BrandonTowell/Capstone-Team-12/Documentation/T12 Capstone Poster 2.1.pptx

Signal Integrity Education
By: Travis Berger and Luis Santiago
Sponsor: Tony Muilenburg Advisor: Dr. James Morris

Background

In order for students and industry members to build an intuition for signal integrity issues Intel developed an educational board to demonstrate these issues with a physical circuit. The Education Engagement Electrical Validation Board E3VB Helps bridge the gap between theory learned in the classroom and common problems that occur while measuring circuits the bench.

Education Engagement
Electrical Validation Board

Objective

Intersymbol Interference


The traces are routed 6 mil apart to induce crosstalk between them . Different inductor values can be selected to magnify the intersymbol interference

The objective of this capstone project was to help improve the E3VB by adding new experiments to the existing board. These experiments were required to work independently from the E3VB but still be capable of being added to the E3VB in a future revision .

Mixed Signal Ground Technique

The goal of this experiment was to highlight signal integrity issues that occur with improper grounding when a board contains both analog and digital circuity.


Victim line with no aggressors


Transmission line with two
aggressor on each side


Analog signal without digital
Interference


Analog signal with isolated
GND planes

Current Experiments

- Crosstalk
- Decoupling
- Corners and Vias
- Mystery Traces
- Simultaneous Switching Noise
- LCR Transmission Lines
- Driver Circuit Comparison
- Package Differences
- Intersymbol Interference

The goal of this experiment was to expand on the Intersymbol Interference and the Crosstalk experiments currently on the E3VB. This experiment used four aggressor lines in parallel to show the effects on a nearby victim line. An LFSR was used to create a random pattern generator for each trace. This shows that the effect on the signal depends on both the previous symbols and the nearby signals.


Analog signal with shared
return path

Department of Electrical and Computer Engineering
