BrandonTowell/Capstone-Team-12/Documentation/T12 Final Presentation.pptx

## Signal Integrity Education

June 2015
Team 12
Owners: Travis Berger, Luis Santiago

## Objective

- The objective of this Capstone Project was to create two experiment boards that help students build an intuition for signal integrity issues.

## Experiments

- Mixed Signal Ground Techniques
- ISI/Crosstalk

## Mixed Signal Ground Techniques

Digital Circuity With
Semi-Isolated Ground Plane

Return Path B

Return Path A

Analog Circuity

Source

Isolation

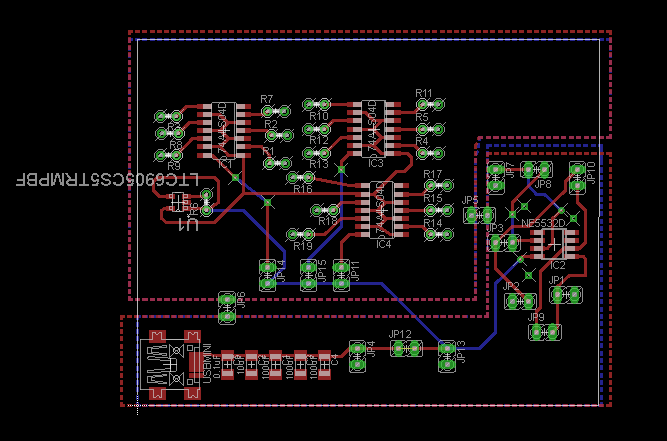
[picture p22: figure]

## MSGT Measurement results

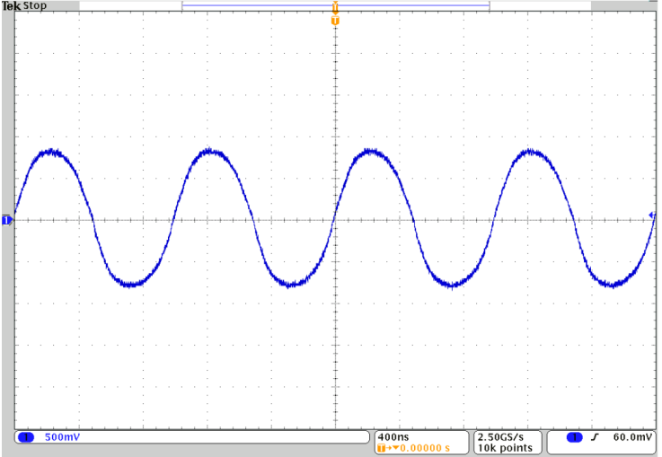
[picture p23: figure]
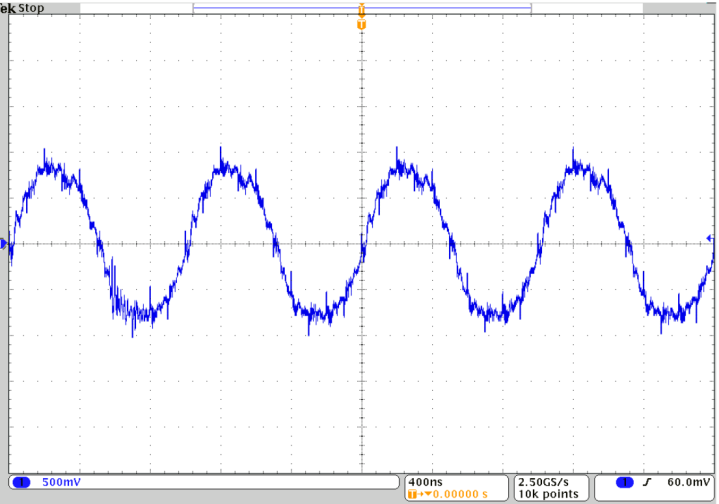
[picture p24: figure]
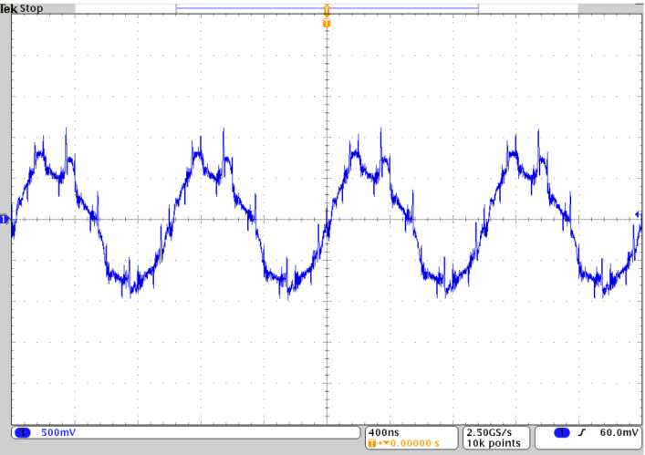
[picture p25: figure]

Analog signal without digital
Interference

## ISI/Crosstalk Experiment


## ISI Finished Board

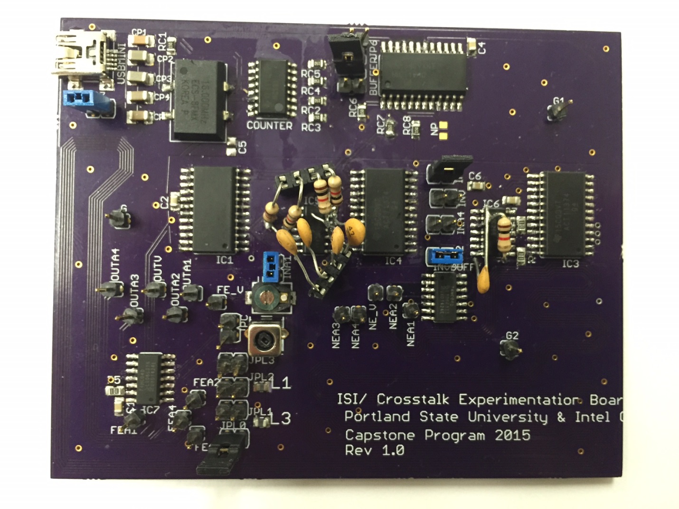
[picture p26: figure]

## ISI Measurement Results


## Testing Approach

- Modular Testing
- Integrated Testing

## Testing

- Modular testing breakout boards
- Integrated testing of CLK and loaded inverter

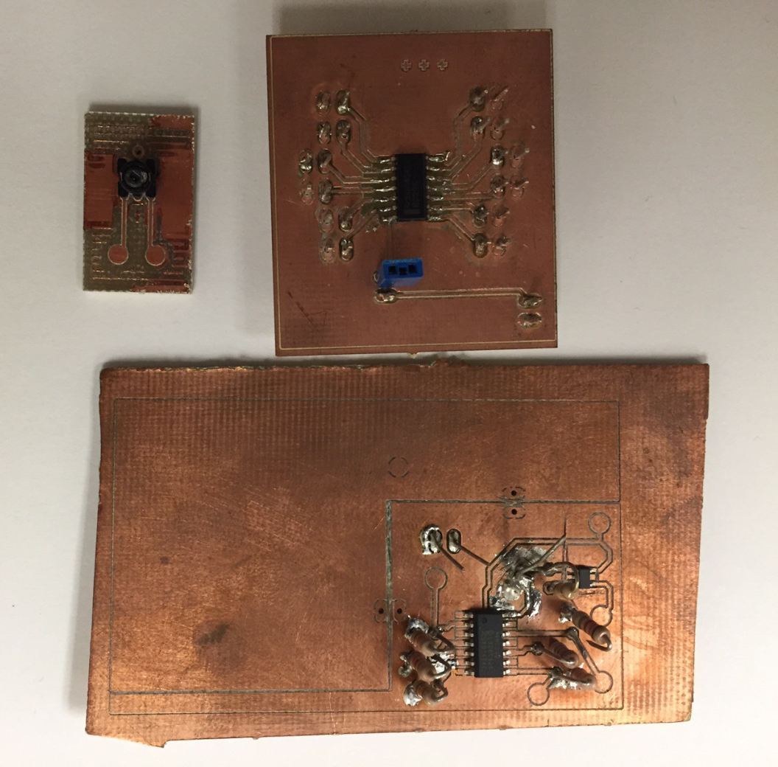
[picture p27: figure]

## Main Problems

  - Problems due to time constraints and loss of resources (two team members)
  - Specific problems with MSGT
  - Specific problems with ISI

## Problem Solutions

  - Board Modifications
  - Layout Changes
  - Scope Changes

## Conclusion

- Thank you Tony
- Thank you to Intel for supporting our project
- Thank you to Dr. Morris for meeting each week and helping with the process.
