BrandonTowell/Capstone-Team-12/Documentation/Prelim Blk Diagram MSE.docx

Block diagram of Mixed Signal Ground Techniques Experiment

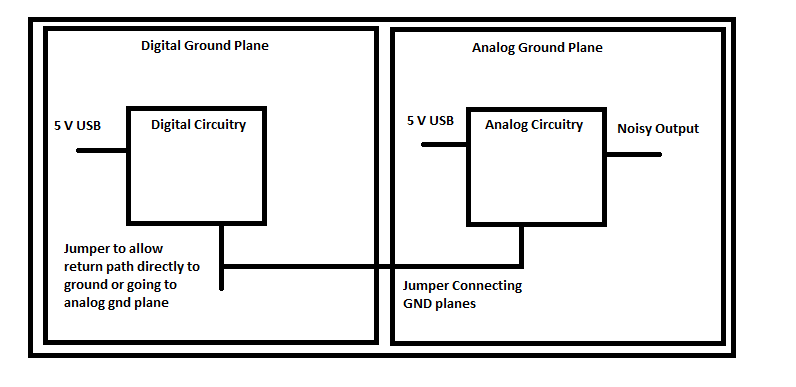
[picture p30: figure]
