BrandonTowell/Capstone-Team-12/Documentation/WPRs/05_17/WPR_Berger_05_17.docx

Weekly Progress Report

T12

Travis Berger

Week ending 05/17/2015

Completed Tasks:

1. Stuffed and baked MSG experiment board
2. Discussed testplan
3. Tested ISI experiment. There is a problem with the Flip Flops and the XNOR device. Isolated these two devices and they didn’t work even in an isolated state.
4. Tested MSG experiment. 100MHz clock had wrong part ordered. Possible expedited re-order will fix this problem.

Tasks to Be Completed Next Week:

1. Meet with Tony for help with experiment fixes.
2. Design Capstone Poster
3. Try to fix problems with both experiments
