BrandonTowell/Capstone-Team-12/Documentation/WPRs/05_10/WPR_Berger_05_10.docx

Weekly Progress Report

T12

Travis Berger

Week ending 05/10/2015

Completed Tasks:

1. Stuffed and baked ISI experiment board
2. Discussed testplan
3. Tested ISI experiment for shorts. Ran into trouble with power connector. Wrong type of USB connector was ordered. Correct type is on its way and power supply will be used in the mean time for a work around.

Tasks to Be Completed Next Week:

1. Create testplan for both experiments
2. Stuff and bake MSG experiment board (when it comes in)
3. Start testing MSG experiment board (When it comes in)
4. Finish testing ISI board.
