BrandonTowell/Capstone-Team-12/Documentation/WPRs/04_26/WPR_Berger_04_26.docx

Weekly Progress Report

T12

Travis Berger

Week ending 04/26/2015

Completed Tasks:

1. Troubleshot layout prototype. Found errors in digital routed portion.
2. Routed test board prototype in EPL that isolated digital portion for further troubleshooting.
3. Helped characterize variable inductor for ISI experiment.

Tasks to Be Completed Next Week:

1. Ship boards to OSH park for routing (Thursday).
2. Stuff and test testboard layout. (Monday/Tuesday)
3. Create testplan
