BrandonTowell/Capstone-Team-12/Documentation/WPRs/04_26/WPR_Santiago_04_26.docx

Weekly Progress Report

T12

Luis Santiago

Week ending 04/26/2015

Completed Tasks:

1. Fixed traces per recommendation from Thursdays meeting.
2. Added Decoupling capacitors.
3. Helped layout new test board for MSG experiment.

Tasks to Be Completed Next Week:

1. Ship boards to OSH park for routing (Thursday)
2. Create testplan
3. Double check variable inductor footprint size. Time permitting use EPL to layout test board.
