BrandonTowell/Capstone-Team-12/Documentation/WPRs/04_18/WPR_Berger_04_19.docx

Weekly Progress Report

T12

Travis Berger

Week ending 04/19/2015

Completed Tasks:

1. Held layout review meeting
2. Routed board in EPL. Ran into significant problems trying to test board.

Tasks to Be Completed Next Week:

1. Ship boards to OSH park for routing.
2. Finalize first draft of experiment and start the review editing process.
3. Create testplan
