BrandonTowell/Capstone-Team-12/Documentation/WPRs/04_18/WPR_Santiago_04_19.docx

Weekly Progress Report

T12

Luis Santiago

Week ending 04/19/2015

Completed Tasks:

1. Held layout review meeting
2. Fixed 400+ errors in layout board file.

Tasks to Be Completed Next Week:

1. Ship boards to OSH park for routing
2. Finalize first draft of experiment and start the review editing process
3. Create testplan
