BrandonTowell/Capstone-Team-12/Documentation/WPRs/04_18/WPR_Gibbs_04_18.docx

WPR

Kris Gibbs

Week ending 4/18/15

This week

- Routed isi board
- Made a prototype isi board in the epl to check size of components
- Corrected errors
- Ordered more parts

Next week

- Finalize layout
- Send boards off to Oshpark
- Help with experiment documentation
