BrandonTowell/Capstone-Team-12/Documentation/WPRs/04_12/WPR_Berger_04_12.docx

Weekly Progress Report

T12

Travis Berger

Week ending 04/12/2015

Completed Tasks:

1. Combined power supply design with MSG schematic in Eagle.
2. Created layout.
3. Worked on Experiment Manual for experiment.
4. Had schematic design review with group.
5. Met with Tony and Luis to discuss experiments.

Tasks to Be Completed Next Week:

1. When parts arrive test parts on protoboard to confirm setup.
2. Route board in EPL to test experiment before shipping out.
3. Hold a layout review. If review is satisfactory ship board schematics to be routed.
