BrandonTowell/Capstone-Team-12/Documentation/WPRs/04_12/Santiago WPR 4-12.docx

Weekly Progress Report

T12

LUIS SANTIAGO

Week ending 04/12/2015

Completed Tasks:

1. Reviewed schematic with Tony
2. Created new eagle parts for added components
3. Modify schematic to with new parts
4. Group review of schematic (different from1)

Tasks to Be Completed Next Week:

1. Write experiment
2. Review route if needed
