BrandonTowell/Capstone-Team-12/Documentation/WPRs/04_12/WPR_Gibbs_04_12.docx

WPR

Kris Gibbs

Week ending 4/12/15

This week

- Ordered more parts
- Started routing board

Next week

- Finalize board layout for ISI experiment
- Final part order
