BrandonTowell/Capstone-Team-12/Documentation/WPRs/04_05/WPR_Berger_04_05.docx

Weekly Progress Report

T12

Travis Berger

Week ending 04/05/2015

Completed Tasks:

1. Created preliminary schematic for experiment changes.
2. Tested original experiment with poor results. Redesigned experiment.
3. Worked on Experiment Manual for experiment.
4. Ordered new parts for experiment.
  a. 100 MHz Clock: LTC6905
  b. Hex Inverter: SN5404
  c. Precision OpAmp: 5532

Tasks to Be Completed Next Week:

1. Get power supply design from Kris and Luis. Combine power supply design with MSG schematic into Eagle.
2. Create layout.
3. Work on first draft of experiment manual.
