BrandonTowell/Capstone-Team-12/Documentation/WPRs/04_05/WPR_Towell_04_05.docx

Weekly Progress Report

T12

Brandon Towell

Week ending 04/05/2015

Completed Tasks:

1. Designed Schematic
2. Built prototype for connectors experiment
3. Started Lab manual

Tasks to Be Completed Next Week:

1. Design Layout
2. Finish Experiment Manual
