BrandonTowell/Capstone-Team-12/Documentation/WPRs/04_05/WPR_Gibbs_04_05.docx

WPR

Kris Gibbs

Week ending 4/5/15

This week

- Finalized power and clock schematic

Next week

- Finalize board layout for ISI experiment
