BrandonTowell/Capstone-Team-12/Documentation/WPRs/03_22/WPR_Towell_03_22.docx

Weekly Progress Report

T12

Brandon Towell

Week ending 03/22/2015

Completed Tasks:

1. Edited deliverables and requirements to project proposal
2. Edited project schedule again
3. Edited Connector write up and added to the project proposal
4. Met with Faust for Capstone update

Tasks to Be Completed Next Week:

1. Design Protoboard
2. Design Schematic
3. Write Experiment Manual
