BrandonTowell/Capstone-Team-12/Documentation/WPRs/03_29/WPR_Towell_03_29.docx

Weekly Progress Report

T12

Brandon Towell

Week ending 03/29/2015

Completed Tasks:

1. Edited deliverables and requirements to project proposal
2. Edited project schedule again
3. Built prototype for connectors experiment
4. Met with Faust for Capstone update

Tasks to Be Completed Next Week:

1. Design Schematic
2. Write Experiment Manual
