BrandonTowell/Capstone-Team-12/Documentation/WPRs/03_29/WPR_Berger_03_29.docx

Weekly Progress Report

T12

Travis Berger

Week ending 03/29/2015

Completed Tasks:

1. Met with group Tuesday at 5:30 PM to go over detailed experiment documents and create new project schedule
2. Contacted Prof. Faust and see if he can meet with us to go over new schedule
3. Figure out meeting time for Advisor/Sponsor meetings for Spring Quarter
  a. Meetings will be held Monday at 8:00 AM

Tasks to Be Completed Next Week:

1. Get power supply design from Kris and Luis. Combine power supply design with MSG schematic into Eagle.
2. Create layout from schematic.
3. Try to get first layout routed.
