BrandonTowell/Capstone-Team-12/Documentation/WPRs/03_22/WPR_Gibbs_03_22.docx

WPR

Kris Gibbs

Week ending 3/22/15

This week

- Worked on power schematic in Eagle for ISI experiment

Next week

- Work on timer schematic in Eagle for ISI experiment
- Write first draft of ISI experiment manual
