BrandonTowell/Capstone-Team-12/Documentation/WPRs/03_15/WPR_Gibbs_03_15.docx

WPR

Kris Gibbs

Week ending 3/15/15

This week

- Wrote BOM Document
- Helped develop timeline with group
- Ordered parts

Next week

- Meet with Professor Faust to present new documentation
