BrandonTowell/Capstone-Team-12/Documentation/WPRs/02_15/Santiago WPR 2-15.docx

Weekly Progress Report

T12

LUIS SANTIAGO

Week ending 02/15/2015

Completed Tasks:

1. Decided suggested ISI redesign of ISI experiment.
2. Researched software available at PSU to make modification to the board

Tasks to Be Completed Next Week:

1. Meet with Tony to for approval of experiments
2. Research experiment if approved
