BrandonTowell/Capstone-Team-12/Documentation/WPRs/02_22/Santiago WPR 2-22.docx

Weekly Progress Report

T12

LUIS SANTIAGO

Week ending 02/22/2015

Completed Tasks:

1. After meeting with Tony Kris and I will Work on new ISI experiment
2. Did Initial Schematic for new ISI experiment

Tasks to Be Completed Next Week:

1. Think about LSFR implementation

Issues:

Tony suggested LSFR for random bit generation and multiple transmission lines
