BrandonTowell/Capstone-Team-12/Documentation/WPRs/03_08/Santiago WPR 3-8.docx

Weekly Progress Report

T12

LUIS SANTIAGO

Week ending 03/08/2015

Completed Tasks:

1. Shared Schematic with Kris
2. Divided task with Kris

Kris is doing power and clock

I did TL and will do LSFR

3. Help make wiki and created links to documents.

Tasks to Be Completed Next Week:

1. Order missing part of LSFR
2. Check if oscilloscopes in campus has persistence mode to record many transition sequences

Issues:

Tony still likes the idea of an always changing LSFR (without a loop to hold value) and will like to demo test both options if possible.
