BrandonTowell/Capstone-Team-12/Documentation/WPRs/03_08/WPR_Berger_03_08.docx

Weekly Progress Report

T12

Travis Berger

Week ending 03/08/2015

Completed Tasks:

1. Created BOM of parts needed for Mixed Signal Experiment. Parts to be ordered on Tuesday after confirming digital parts with Luis.
2. Updated the Project Proposal and created a Gantt Chart to reflect the new direction of the project.
3. Created Project Wiki in GitHub and moved all documentation and WPR’s from Google Documents to GitHub.
4. Emailed Dr. Morris and Professor Faust notifying them of the document changes and provided them with the web address to the Wiki.
5. Completed Self/Group assessment.

Tasks to Be Completed Next Week:

1. Give BOM to Kris and place an order with Digikey on Tuesday.
2. Start preliminary layout design with the goal to have a layout ready to go by the time the parts arrive. <Pushed Back because of documentation update and creation of different repository and wiki.>
3. Further research into mixed signal ground techniques and problems.
