BrandonTowell/Capstone-Team-12/Documentation/WPRs/03_08/WPR_Gibbs_03_08.docx

WPR

Kris Gibbs

Week ending 3/8/15

This week

- Got BOM together
- Worked on eagle layout

Next week

- Order materials
