BrandonTowell/Capstone-Team-12/Documentation/WPRs/01_11/WPR_Gibbs_01_11.docx

WPR

Kris Gibbs

Week ending 1/11/15

This week

- Met with Team to discuss project scope
- Read existing project documentation

Next week

- Read existing project documentation
- Go thru all existing experiments to get familiar with the board
