BrandonTowell/Capstone-Team-12/Documentation/WPRs/01_18/WPR_Gibbs_01_18.docx

WPR

Kris Gibbs

Week ending 1/18/15

This week

- Got familiar with board experiments cross talk 1 and 2
- Wrote project proposal

Next week

- Present project proposal to advisor and sponsor
