BrandonTowell/Capstone-Team-12/Documentation/WPRs/01_25/WPR_Gibbs_01_25.docx

WPR

Kris Gibbs

Week ending 1/25/15

This week

- Met with advisor to go over project proposal

Next week

- Rewrite proposal using advisors suggestions
- Research assigned experiments
1. Packages differences
2. Simultaneous switching
