BrandonTowell/Capstone-Team-12/Documentation/WPRs/02_15/WPR_Gibbs_02_15.docx

WPR

Kris Gibbs

Week ending 2/15/15

This week

- Met with group and decided to do experiments on separate board not changing the original board.

Next week

- Research improvement of ISI experiment.
- Write requirement’s document
