BrandonTowell/Capstone-Team-12/Documentation/WPRs/02_22/WPR_Gibbs_02_22.docx

WPR

Kris Gibbs

Week ending 2/22/15

This week

- Met with sponsor and advisor and presented new experiment ideas and got sign off.
- met with designers to ask questions about the board. Learned that no simulations were done originally.

Next week

- started designing new ISI experiment
