BrandonTowell/Capstone-Team-12/Documentation/WPRs/03_01/WPR_Gibbs_03_01.docx

WPR

Kris Gibbs

Week ending 3/1/15

This week

- Designed new ISI experiment
- Learned eagle cad and made sample board

Next week

- Get list of materials together for ordering
