BrandonTowell/Capstone-Team-12/Documentation/WPRs/01_25/WPR_Towell_01_25.docx

Weekly Progress Report

T12

Brandon Towell

Week ending 01/25/2015

Completed Tasks:

1. Met with Dr. Morris and revised presentation to his specifications.
2. Researched assigned experiments:
  a. Mystery Traces
  b. Decoupling Circuit

Tasks to Be Completed Next Week:

1. Come up with a format for all the experiment so the documentation is the same. (Need to be pushed out two weeks due to proposal scope changes)
2. Meet with advisor and corporate sponsor and present project proposal. (Tony had to reschedule to next week)
3. Research background for assigned projects to add more knowledge into the experiments and not just bullets of “do this, do that”
