BrandonTowell/Capstone-Team-12/Documentation/WPRs/02_01/WPR_Towell_02_01.docx

Weekly Progress Report

T12

Brandon Towell

Week ending 02/01/2015

Completed Tasks:

1. Met with group and practiced presentation.
2. Met with advisor and corporate sponsor and gave formal presentation.

Tasks to Be Completed Next Week:

1. Come up with a format for all the experiments so the documentation is the same.
2. Create first draft of Project Requirements Document for meeting with Tony on Thursday.
3. Research possible connector degradation experiment. Especially look into high frequency and how the connectors distort the signal
