BrandonTowell/Capstone-Team-12/Documentation/WPRs/02_08/WPR_Towell_02_08.docx

Weekly Progress Report

T12

Brandon Towell

Week ending 02/08/2015

Completed Tasks:

1. Researched connector effects.
2. Located Galileo board for Kris and Luis’ experiment
3. Met with Tony and Dr. Morris. Entire Project Scope has changed.

Tasks to Be Completed Next Week:

1. Research different experiments that can be done on a peripheral daughter board.
2. Look at changes that can be made to physical E3VB board.
3. Meet as a group and try to satisfy the new scope of the project knowing we have a time constraint.
