BrandonTowell/Capstone-Team-12/Documentation/WPRs/02_15/WPR_Towell_02_15.docx

Weekly Progress Report

T12

Brandon Towell

Week ending 02/15/2015

Completed Tasks:

1. Met with group and came up with three different daughter board experiments.
2. Researched usability of connector degradation and how high signals will have to be.

Tasks to Be Completed Next Week:

1. At meeting on Tuesday propose experiments to Tony and start working on what is agreed upon for the project.
2. Create first draft of Requirements Document.
3. Allocate tasks to individual team members.
