BrandonTowell/Capstone-Team-12/Documentation/WPRs/02_22/WPR_Towell_02_22.docx

Weekly Progress Report

T12

Brandon Towell

Week ending 02/22/2015

Completed Tasks:

1. Proposed three peripheral experiments to Tony and Dr. Morris. They signed off on the experiments.
2. Created first draft of Requirements Document.
3. Allocated the group members to their correct experiments
4. Researched Connector Experiment.

Tasks to Be Completed Next Week:

1. Continue Research of Connector Experiment.
2. Meet with Morris and Tony to finalize the 3 experiments before physically building them
