BrandonTowell/Capstone-Team-12/Documentation/WPRs/03_01/WPR_Towell_03_01.docx

Weekly Progress Report

T12

Brandon Towell

Week ending 03/01/2015

Completed Tasks:

1. Researched Connectors that I want to use for experiment
2. Ran into issues with HF signals as original connectors were too HF
3. Spoke with Travis and Luis to flesh out the connector experiment and give a better understanding of how it will be laid out

Tasks to Be Completed Next Week:

1. Order the parts needed for protoboard
2. Run signals through protoboard to confirm signal degradation
