BrandonTowell/Capstone-Team-12/Documentation/WPRs/05_31/WPR_Berger_05_31.docx

Weekly Progress Report

T12

Travis Berger

Week ending 05/31/2015

Completed Tasks:

1. Met with Tony and demonstrated experiments. He was happy with the experiments and deemed out project a success. Only Deliverables required by Tony are both boards and instructions for how to run the experiments.
2. Delivered Poster to Kristen before the deadline.
3. Received finished poster. Double checked with team.
4. Met and went over deliverables. Broke up tasks for deliverables amongst each other. Will meet during the week to finalize.

Tasks to Be Completed Next Week:

1. Meet with Dr. Morris and talk about final deliverables.
2. Poster Presentation 06/05 3:00 PM – 5:00 PM
3. Finalize all deliverables.
