BrandonTowell/Capstone-Team-12/Documentation/WPRs/03_22/WPR_Berger_03_22.docx

Weekly Progress Report

T12

Travis Berger

Week ending 03/22/2015

Completed Tasks:

1. Presented updated documents to Professor Faust and Dr. Morris
2. Created detailed document that describes MSGT experiment

Tasks to Be Completed Next Week:

1. Start preliminary layout design with the goal to have a layout ready to go by the time the parts arrive. <Pushed Back because of documentation update and creation of different repository and wiki.>
2. Meet with group Tuesday at 5:30 PM to go over detailed experiment documents and create new project schedule
3. Contact Prof. Faust and see if he can meet with us to go over new schedule
4. Figure out meeting time for Advisor/Sponsor meetings for Spring Quarter
