BrandonTowell/Capstone-Team-12/Documentation/WPRs/03_15/Santiago WPR 3-15.docx

Weekly Progress Report

T12

LUIS SANTIAGO

Week ending 03/15/2015

Completed Tasks:

1. Worked with Tony on LSFR that generate interesting patterns (took over 12hrs, only to end up with an easy solution)
2. Added experiment Description PDS
3. Updated wiki links to documents.

Tasks to Be Completed Next Week:

1. Review LSFR timing to ensure max patterns are generated
2. Meet with Dr Morris and Professor Faust for review of updated documentation.
3. add additional transmission lines to schematic for the cross talk part
4. get accurate values for variables components (maybe following week)

Issues:

Implementation require shifting and initialization ( be creative!!!!)
