BrandonTowell/Capstone-Team-12/Documentation/WPRs/03_15/WPR_Berger_03_15.docx

Weekly Progress Report

T12

Travis Berger

Week ending 03/15/2015

Completed Tasks:

1. Revamped documentation per Professor Faust’s requests.
2. Updated the Project Proposal and created a Gantt Chart to reflect the new direction of the project.
3. Emailed Dr. Morris and Professor Faust notifying them of the document changes and provided them with the web address to the Wiki.
4. Sent Dr. Morris team evaluation.

Tasks to Be Completed Next Week:

1. Start preliminary layout design with the goal to have a layout ready to go by the time the parts arrive. <Pushed Back because of documentation update and creation of different repository and wiki.>
2. Further research into mixed signal ground techniques and problems.
3. Present updated documents to Professor Faust.
