BrandonTowell/Capstone-Team-12/Documentation/WPRs/03_15/WPR_Towell_03_15.docx

Weekly Progress Report

T12

Brandon Towell

Week ending 03/15/2015

Completed Tasks:

1. Parts order for Protoboard
2. Added deliverables and requirements to project proposal
3. Edited project schedule
4. Finished Connector write up and added to the project proposal
5. Brushed up documentation to reflect new scope and deleted old information

Tasks to Be Completed Next Week:

1. Run signals through protoboard to confirm signal degradation
