BrandonTowell/Capstone-Team-12/Documentation/WPRs/03_01/Santiago WPR 3-1.docx

Weekly Progress Report

T12

LUIS SANTIAGO

Week ending 03/01/2015

Completed Tasks:

1. Research LSFR application.
2. Made Changes to schematic (some things did not make sence)

Tasks to Be Completed Next Week:

1. Simulate LSFR with at 4-6 bits to create at least 16 different combinations

Issues:

Using simulation realized that it is nearly impossible to make sense of the data on real time using LSFR. Need to talk to Tony and re-consider.
