BrandonTowell/Capstone-Team-12/Documentation/WPRs/01_18/WPR_Berger_01_18.docx

Weekly Progress Report

T12

Travis Berger

Week ending 01/18/2015

Completed Tasks:

1. Finished reading E3VB user manual.
2. Completed the Crosstalk experiments in the user manual.
3. Finished writing the project proposal to present to corporate sponsor.
4. Created first draft of the project proposal presentation in Power Point.

Tasks to Be Completed Next Week:

1. Come up with a format for all the experiment so the documentation is the same.
2. Research assigned experiments:
  a. LCR Transmission Lines
  b. Corners and Vias.
3. Meet with advisor and corporate sponsor and present project proposal.
