BrandonTowell/Capstone-Team-12/Documentation/WPRs/01_18/WPR_Santiago_01_18.docx

Weekly Progress Report

T12

LUIS SANTIAGO

Week ending 01/18/2015

Completed Tasks:

1. Finished reading E3VB user manual.
2. Completed the Crosstalk experiments in the user manual.
3. Created list and order ( to be placed by Kris) of IC needed to complete experiments
4. Meet, reviewed, contribute to the final project proposal to be presented to corporate sponsor.

Tasks to Be Completed Next Week:

1. Come up with a format for all the experiment so the documentation is the same.
2. Research assigned experiments:
  a. ISI
  b. Driver Ciruit.
3. Meet with advisor and corporate sponsor and present project proposal.
