BrandonTowell/Capstone-Team-12/LSFR Patterns/sketch.png

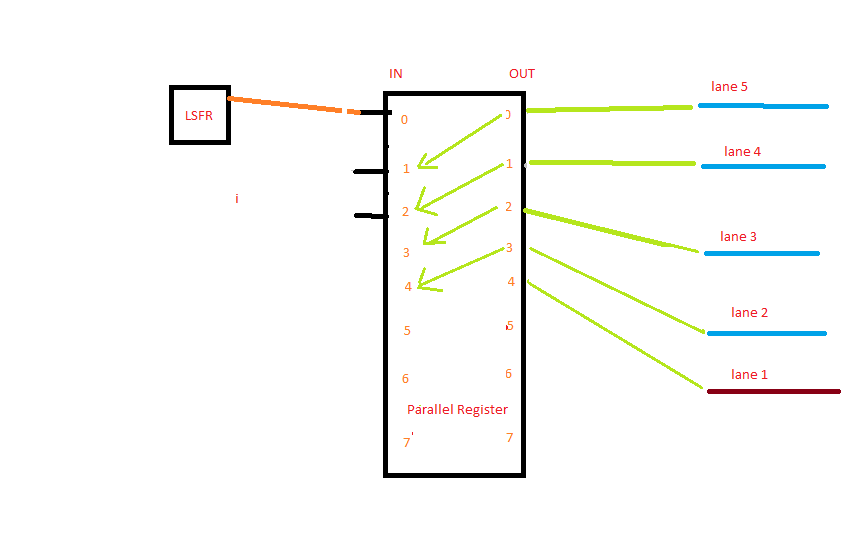
LSFR Patterns/sketch.png
