BrandonTowell/Capstone-Team-12/Documentation/BillOfMaterials_rev2.xlsx

Sheet: ISI_BOM
Qty | Value | Device | Package | Description | Unit Cost | Sub Total
11 |  | JP1E | JP1 | JUMPER | 0.16 | 1.76
1 |  | PINHD-2X4 | 2X04 | PIN HEADER | 0.16 | 0.16
1 |  | USBMINIB | USB-MINIB | USB Connectors | 1.76 | 1.76
7 | .1uF | C | C0805 | CAPACITOR, European symbol | 0.12 | 0.84
1 | .1uF | C-USC1206K | C1206K | CAPACITOR, American symbol | 0.12 | 0.12
1 | .5 uH | PM0805-8N2M-RC | INDC2115X15N | CHIP INDUCTOR, 8.2NH, 600mA, 20%, 4.7GHZ | 0.13 | 0.13
4 | 100 | R-US_M0805 | M0805 | RESISTOR, American symbol | 0.15 | 0.60
2 | 100uf | C-USC1206K | C1206K | CAPACITOR, American symbol | 0.14 | 0.28
2 | 10uF | C-USC1206K | C1206K | CAPACITOR, American symbol | 0.10 | 0.20
8 | 15 | R-US_R0805 | R0805 | RESISTOR, American symbol | 0.10 | 0.80
5 | 1K | R-US_M0805 | M0805 | RESISTOR, American symbol | 0.10 | 0.50
1 | 1K | R-US_R0805 | R0805 | RESISTOR, American symbol | 0.10 | 0.10
1 | 1uH | PM0805-8N2M-RC | INDC2115X15N | CHIP INDUCTOR, 8.2NH, 600mA, 20%, 4.7GHZ | 0.10 | 0.10
5 | 50pf | C | C0805 | CAPACITOR, European symbol | 0.14 | 0.70
2 | 74266D | 74266D | SO14 | Quadruple EXCLUSIVE-NOR (XNOR), open-collector | 0.57 | 1.14
1 | 74AC11240D | 74AC11240D | SO24W | Octal BUFFER/DRIVER | 4.20 | 4.20
3 | 74AC11374D | 74AC11374D | SO24W | Octal D-type edge triggered FLIP FLOP, 3-state (http://www.ti.com/lit/ds/symlink/74act11374.pdf) | 4.00 | 12.00
2 | 74HC04D | 74HC04D | SO14 | Hex INVERTER (http://www.ti.com/lit/ds/symlink/sn74hc14.pdf) | 0.56 | 1.12
1 | 74HC191NS | 74HC191NS | SO16NS | Synchronous UP/DOWN COUNTER (http://www.digikey.com/product-detail/en/0/296-8261-5-ND) | 0.63 | 0.63
1 | C-TRIMM | C-TRIMM | C_TRIM | Variable capacitor (http://media.digikey.com/pdf/Data%20Sheets/Sprague-Goodman%20PDFs/GX,GY,GZ%20Series.pdf) | 2.91 | 2.91
1 | ECS-8FX | ECS-8FX | ECS-8FX | SMD Clock Oscillator (http://www.ecsxtal.com/store/pdf/ecs-8fx.pdf) | 4.13 | 4.13
18 | JP1 | JP1 | JP1 | jumpers | 0.16 | 2.88
1 | RF_INDUCTOR | RF_INDUCTOR | ADJ_IND_NON_STD_PKG | Variable Inductor (http://media.digikey.com/pdf/Data%20Sheets/Toko%20PDFs/5K_5KM.pdf) | 1.13 | 1.13
 |  |  |  |  | Total | $38.19
 |  |  |  | Board manufacture | 3 for | $64.25
 |  |  |  | Total Cost |  | $102.44

Sheet: MSGP_BOM
Parts
Qty | Value | Device | Package | Description | Unit Cost | Sub Total
15 |  | JP1E | JP1 | JUMPER | 0.16 | $2.40
19 |  | R-US_0204/2V | 0204V | RESISTOR, American symbol | 0.10 | $1.90
1 |  | USBMINIB | USB-MINIB | USB Connectors | 1.76 | $1.76
1 | 0.1uF | C-USC1206K | C1206K | CAPACITOR, American symbol | 0.12 | $0.12
3 | 100uF | C-USC1206K | C1206K | CAPACITOR, American symbol | 0.12 | $0.36
1 | 10uF | C-USC1206K | C1206K | CAPACITOR, American symbol | 0.12 | $0.12
3 | 74ALS04D | 74ALS04D | SO14 | Hex INVERTER | 0.56 | $1.68
1 |  | LTC6905IS5 | TSOT-23-5 | Oscillator, Silicon | 3.32 | $3.32
1 | NE5532D | NE5532D | SO08 | AUDIO AMPLIFIER | 0.88 | $0.88
 |  |  |  |  | Total | $12.54
 |  |  |  | Board manufacture cost | 3 for
 |  |  |  |  | Total Cost | $12.54
