BrandonTowell/Capstone-Team-12/Eagle/ISI_experiement.pdf

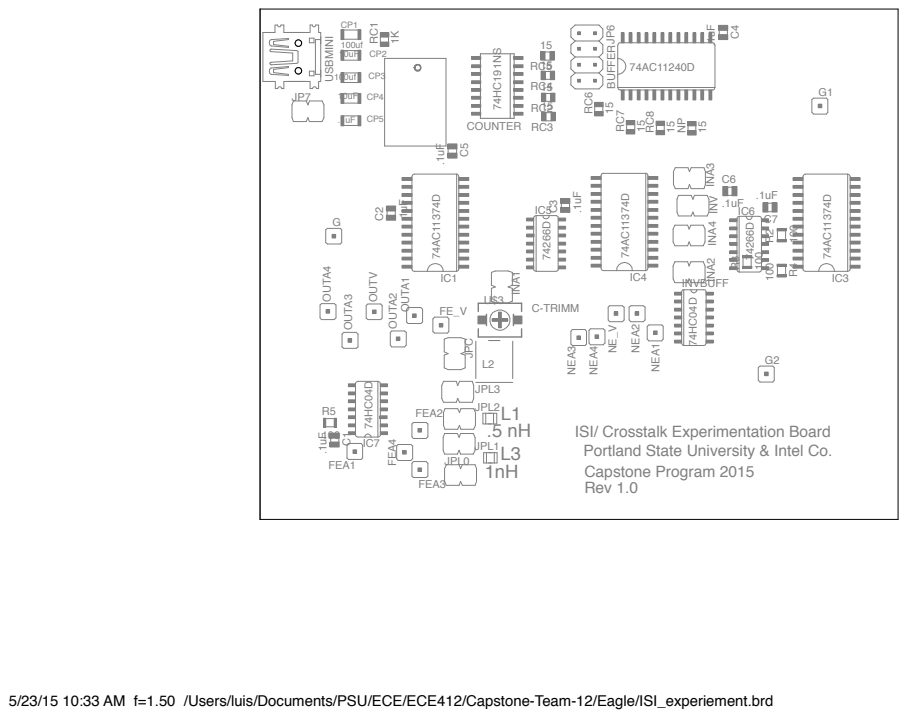
[picture p32: page 1]

ISI/ Crosstalk Experimentation Board
Portland State University & Intel Co.
Capstone Program 2015
Rev 1.0

5/23/15 10:33 AM f=1.50 /Users/luis/Documents/PSU/ECE/ECE412/Capstone-Team-12/Eagle/ISI_experiement.brd
