BrandonTowell/Capstone-Team-12/Eagle/ISI_experiement.brd

## EAGLE design Eagle/ISI_experiement.brd (2015-06-10)

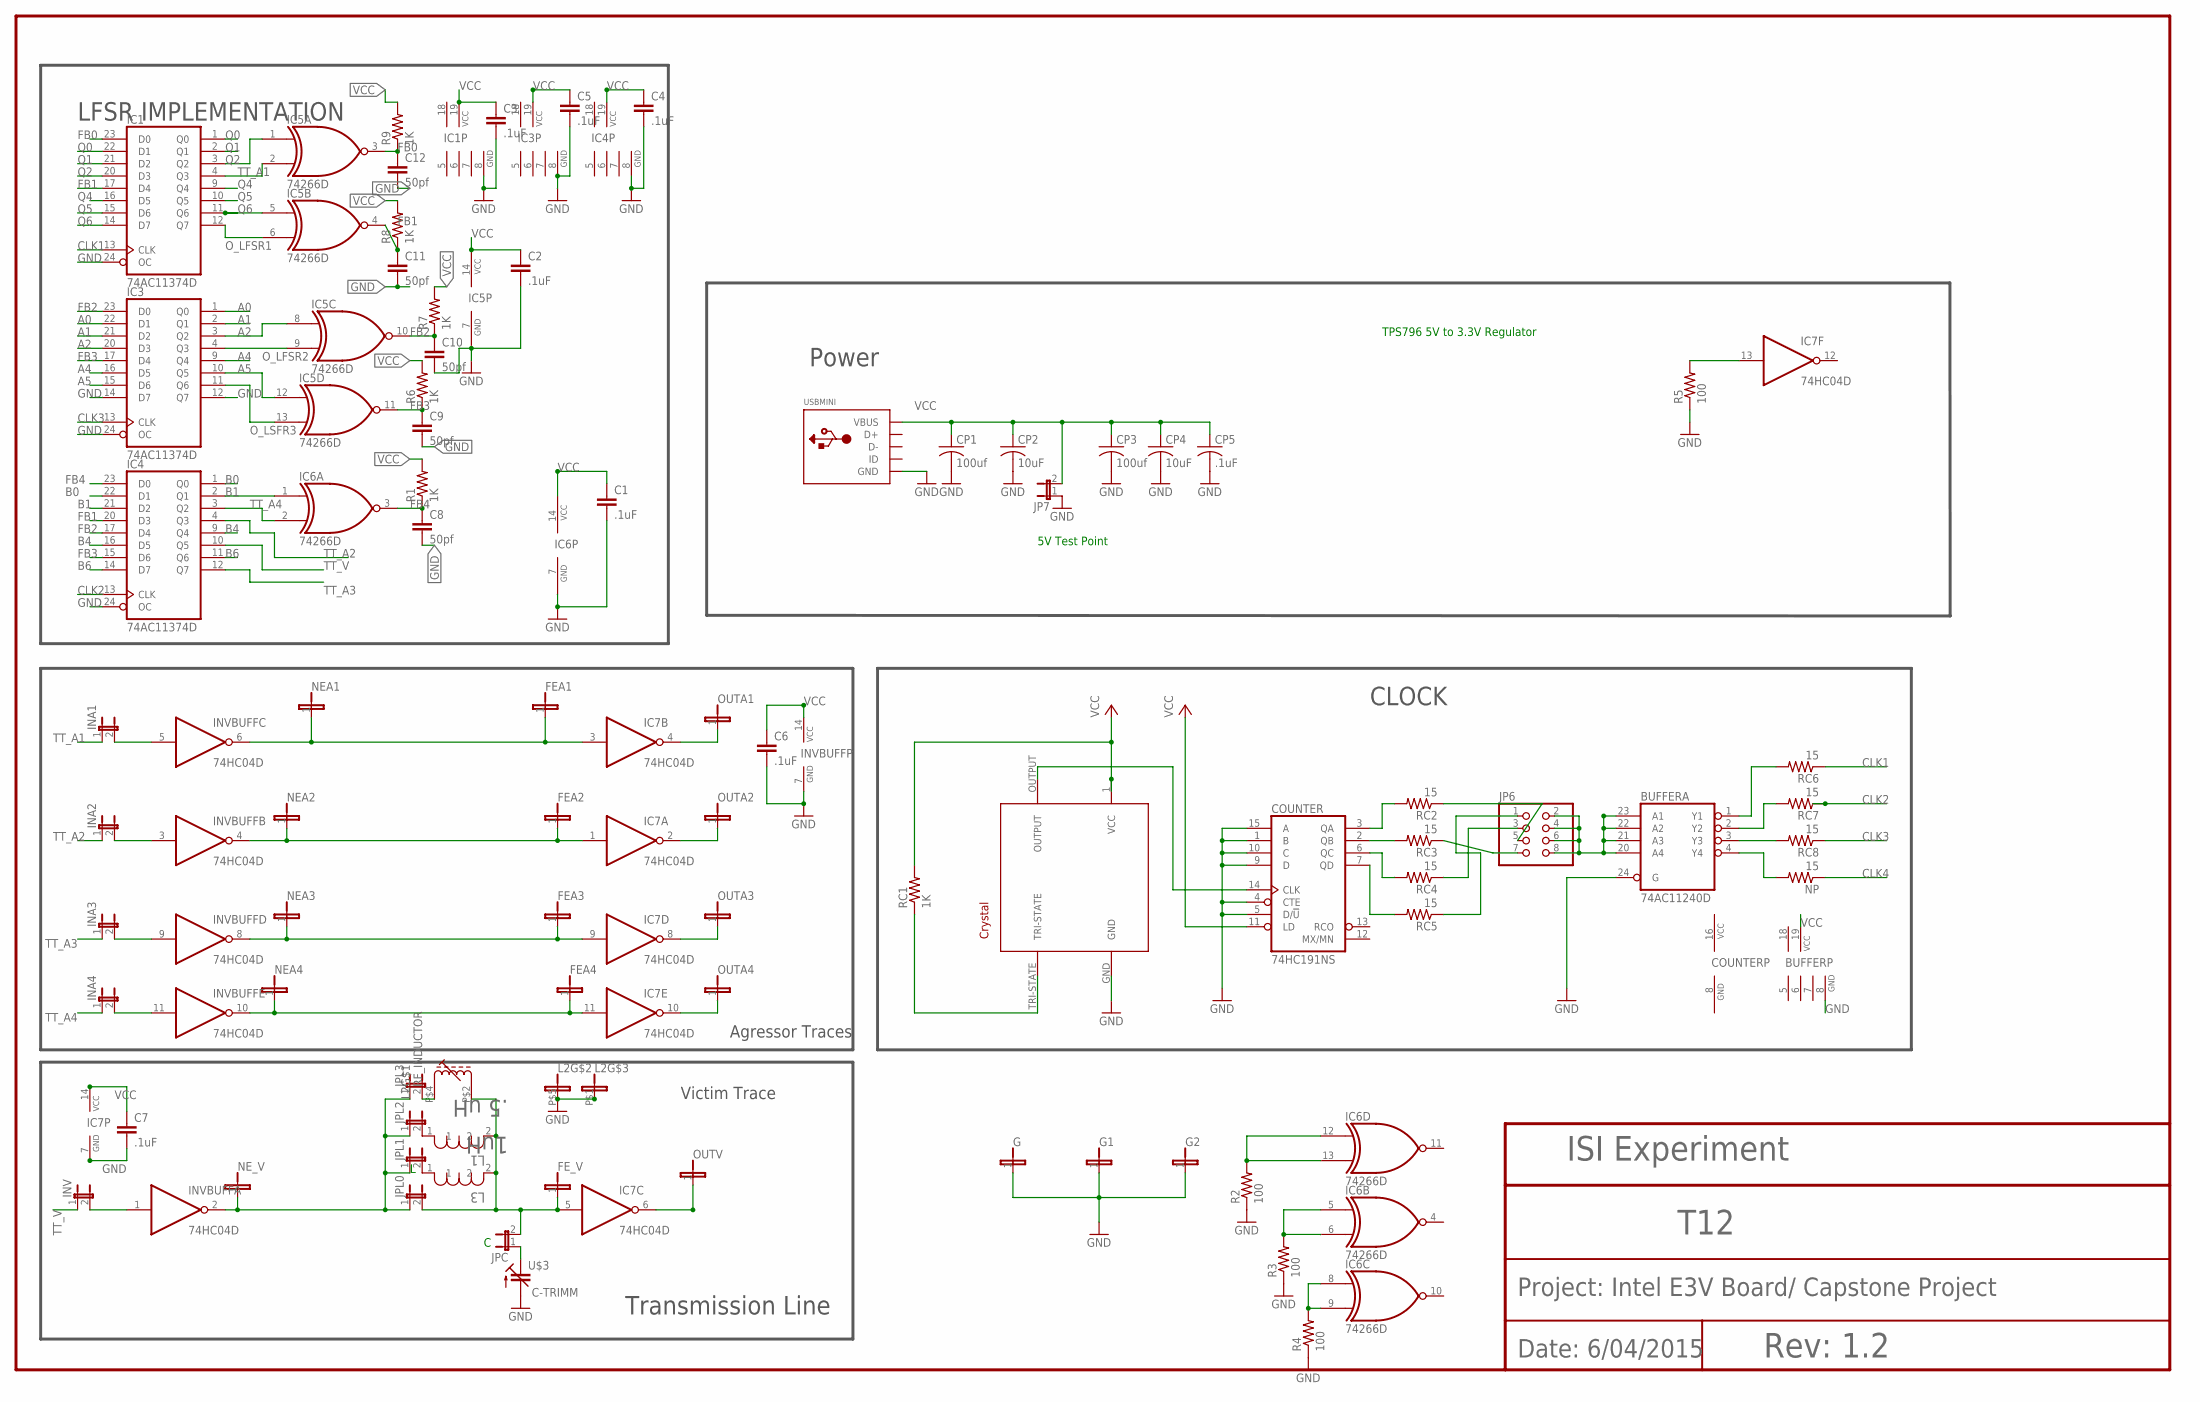
[picture p33: schematic ISI_experiement.sch]

Parts:
BUFFER: 74AC11240D; SO24W
C1, C2, C3, C4, C5, C6, C7: .1uF; C0805
C8, C9, C10, C11, C12: 50pf; C0805
COUNTER: 74HC191NS; SO16NS
CP1, CP3: 100uf; C1206K
CP2, CP4: 10uF; C1206K
CP5: .1uF; C1206K
FEA1, FEA2, FEA3, FEA4: JP1
FE_V: JP1
G, G1, G2: JP1
IC1, IC3, IC4: 74AC11374D; SO24W
IC5, IC6: 74266D; SO14
IC7: 74HC04D; SO14
INA1, INA2, INA3, INA4: JP1E; JP1
INV: JP1E; JP1
INVBUFF: 74HC04D; SO14
JP6: PINHD-2X4; 2X04
JP7: JP1E; JP1
JPC: JP1E; JP1
JPL0, JPL1, JPL2, JPL3: JP1E; JP1
L1: .5 uH; INDC2115X15N
L2: RF_INDUCTOR; ADJ_IND_NON_STD_PKG
L3: 1uH; INDC2115X15N
NEA1, NEA2, NEA3, NEA4: JP1
NE_V: JP1
NP: 15; R0805
OUTA1, OUTA2, OUTA3, OUTA4: JP1
OUTV: JP1
R1, R6, R7, R8, R9: 1K; M0805
R2, R3, R4, R5: 100; M0805
RC1: 1K; R0805
RC2, RC3, RC4, RC5, RC6, RC7, RC8: 15; R0805
U$1: ECS-8FX
U$3: C-TRIMM; C_TRIM
USBMINI: USBMINIB; USB-MINIB

Connections:
1: FEA1.1, IC7.3 (I), INVBUFF.6 (O), NEA1.1
2: FEA2.1, IC7.1 (I), INVBUFF.4 (O), NEA2.1
3: FEA3.1, IC7.9 (I), INVBUFF.8 (O), NEA3.1
8: FEA4.1, IC7.11 (I), INVBUFF.10 (O), NEA4.1
A0: IC3.1 (Q0), IC3.22 (D1)
A1: IC3.2 (Q1), IC3.21 (D2)
A2: IC3.3 (Q2), IC3.20 (D3), IC5.8 (I0)
A4: IC3.9 (Q4), IC3.16 (D5)
A5: IC3.10 (Q5), IC3.15 (D6), IC5.12 (I0)
B0: IC4.1 (Q0), IC4.22 (D1)
B1: IC4.2 (Q1), IC4.21 (D2), IC6.1 (I0)
B4: IC4.9 (Q4), IC4.16 (D5)
B6: IC4.11 (Q6), IC4.14 (D7)
CLK1: IC1.13 (CLK), RC6.1
CLK2: IC4.13 (CLK), RC7.1
CLK3: IC3.13 (CLK), RC8.1
CLK4: NP.1
CRY_OUT: COUNTER.14 (CLK), U$1.OUTPUT
FB0: C12.1, IC1.23 (D0), IC5.3 (O), R9.1
FB1: C11.1, IC1.17 (D4), IC4.20 (D3), IC5.4 (O), R8.1
FB2: C10.1, IC3.23 (D0), IC4.17 (D4), IC5.10 (O), R7.1
FB3: C9.1, IC3.17 (D4), IC4.15 (D6), IC5.11 (O), R6.1
FB4: C8.1, IC4.23 (D0), IC6.3 (O), R1.1
GND: BUFFER.5 (GND), BUFFER.6 (GND), BUFFER.7 (GND), BUFFER.8 (GND), BUFFER.24 (G), C1.2, C2.2, C3.2, C4.2, C5.2, C6.2, C7.2, C8.2, C9.2, C10.2, C11.2, C12.2, COUNTER.1 (B), COUNTER.4 (CTE), COUNTER.5 (D/!U), COUNTER.8 (GND), COUNTER.9 (D), COUNTER.10 (C), COUNTER.15 (A), CP1.2, CP2.2, CP3.2, CP4.2, CP5.2, G.1, G1.1, G2.1, IC1.5 (GND), IC1.6 (GND), IC1.7 (GND), IC1.8 (GND), IC1.24 (OC), IC3.5 (GND), IC3.6 (GND), IC3.7 (GND), IC3.8 (GND), IC3.12 (Q7), IC3.14 (D7), IC3.24 (OC), IC4.5 (GND), IC4.6 (GND), IC4.7 (GND), IC4.8 (GND), IC4.24 (OC), IC5.7 (GND), IC6.7 (GND), IC7.7 (GND), INVBUFF.7 (GND), JP7.1, L2.P$1 (1), L2.P$5 (1), R2.1, R3.1, R4.1, R5.1, U$1.GND, U$3.- (G), USBMINI.GND
unnamed: INA2.2, INVBUFF.3 (I)
unnamed: JPL3.2, L2.P$4 (A1)
unnamed: FE_V.1, IC7.5 (I), JPC.2, JPL0.2, L1.2, L2.P$2 (E1), L3.2
unnamed: RC1.1, U$1.TRI-STATE
unnamed: COUNTER.7 (QD), RC5.2
unnamed: JPC.1, U$3.+
unnamed: IC7.4 (O), OUTA1.1
unnamed: INA1.2, INVBUFF.5 (I)
unnamed: COUNTER.3 (QA), RC2.2
unnamed: IC6.12 (I0), IC6.13 (I1), R2.2
unnamed: IC7.6 (O), OUTV.1
unnamed: JPL2.2, L1.1
unnamed: IC7.10 (O), OUTA4.1
unnamed: IC7.2 (O), OUTA2.1
unnamed: INA4.2, INVBUFF.11 (I)
unnamed: INV.2, INVBUFF.1 (I)
unnamed: COUNTER.2 (QB), RC3.2
unnamed: JPL1.2, L3.1
unnamed: INA3.2, INVBUFF.9 (I)
unnamed: COUNTER.6 (QC), RC4.2
unnamed: IC6.5 (I0), IC6.6 (I1), R3.2
unnamed: JP6.5, RC2.1
unnamed: JP6.3, RC4.1
unnamed: JP6.7, RC3.1
unnamed: JP6.1, RC5.1
unnamed: BUFFER.20 (A4), BUFFER.21 (A3), BUFFER.22 (A2), BUFFER.23 (A1), JP6.2, JP6.4, JP6.6, JP6.8
unnamed: BUFFER.1 (Y1), RC6.2
unnamed: BUFFER.2 (Y2), RC7.2
unnamed: BUFFER.3 (Y3), RC8.2
unnamed: BUFFER.4 (Y4), NP.2
unnamed: IC6.8 (I0), IC6.9 (I1), R4.2
unnamed: IC7.13 (I), R5.2
OUTA4: IC7.8 (O), OUTA3.1
O_LFSR1: IC1.12 (Q7), IC5.6 (I1)
O_LFSR2: IC3.4 (Q3), IC5.9 (I1)
O_LSFR3: IC3.11 (Q6), IC5.13 (I1)
Q0: IC1.1 (Q0), IC1.22 (D1)
Q1: IC1.2 (Q1), IC1.21 (D2)
Q2: IC1.3 (Q2), IC1.20 (D3), IC5.1 (I0)
Q4: IC1.9 (Q4), IC1.16 (D5)
Q5: IC1.10 (Q5), IC1.15 (D6)
Q6: IC1.11 (Q6), IC1.14 (D7), IC5.5 (I0)
TT_A1: IC1.4 (Q3), IC5.2 (I1), INA1.1
TT_A2: IC4.4 (Q3), INA2.1
TT_A3: IC4.12 (Q7), INA3.1
TT_A4: IC4.3 (Q2), IC6.2 (I1), INA4.1
TT_V: IC4.10 (Q5), INV.1
V1: INVBUFF.2 (O), JPL0.1, JPL1.1, JPL2.1, JPL3.1, NE_V.1
VCC: BUFFER.18 (VCC), BUFFER.19 (VCC), C1.1, C2.1, C3.1, C4.1, C5.1, C6.1, C7.1, COUNTER.11 (LD), COUNTER.16 (VCC), CP1.1, CP2.1, CP3.1, CP4.1, CP5.1, IC1.18 (VCC), IC1.19 (VCC), IC3.18 (VCC), IC3.19 (VCC), IC4.18 (VCC), IC4.19 (VCC), IC5.14 (VCC), IC6.14 (VCC), IC7.14 (VCC), INVBUFF.14 (VCC), JP7.2, R1.2, R6.2, R7.2, R8.2, R9.2, RC1.2, U$1.1 (VCC), USBMINI.VBUS

Notes on the sheet:
LFSR IMPLEMENTATION
Transmission Line
Power
CLOCK
ISI Experiment
T12
Rev: 1.2
Date: 6/04/2015
Project: Intel E3V Board/ Capstone Project
TPS796 5V to 3.3V Regulator
5V Test Point
Victim Trace
Agressor Traces

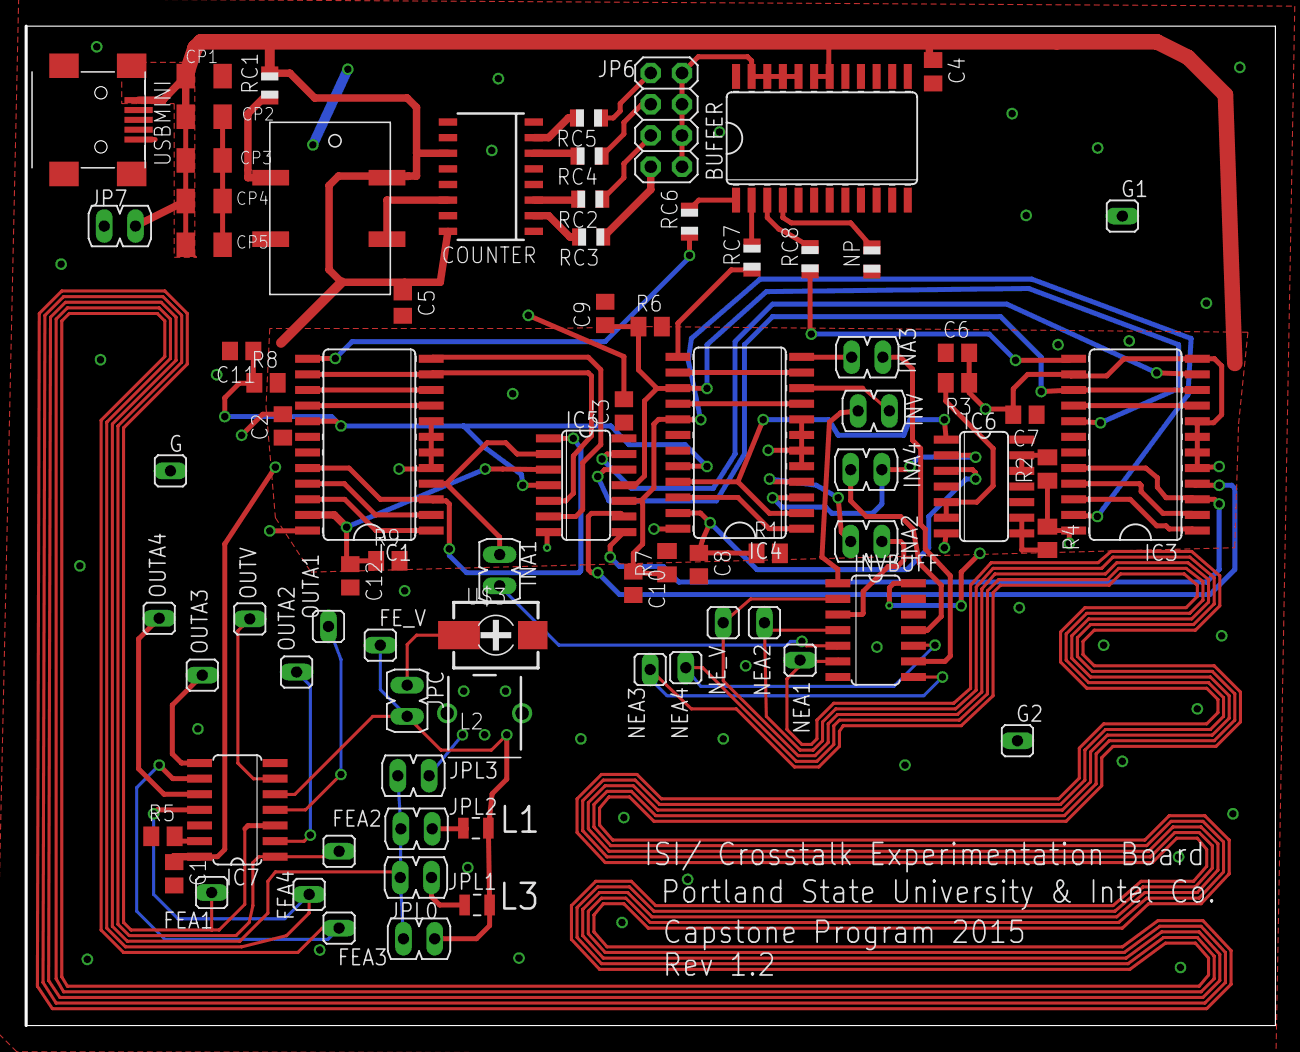
[picture p34: board ISI_experiement.brd from above]

Board: 2 copper layers, 101.6 x 81.3 mm, 80 parts (0 on the bottom side), 72 nets.
