BrandonTowell/Capstone-Team-12/Eagle/MSGP/MSGP_rev2.brd

## EAGLE design Eagle/MSGP/MSGP_rev2.brd (2015-06-10)

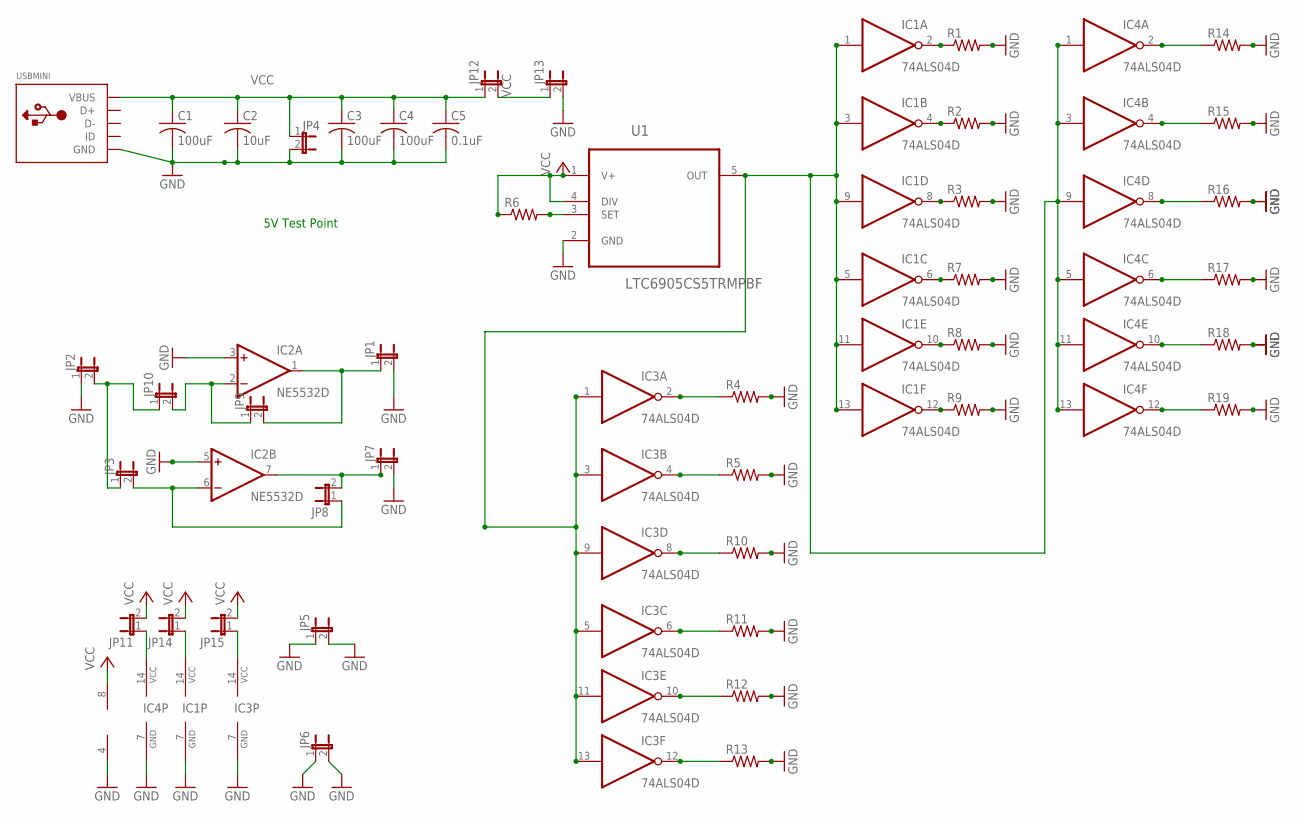
[picture p35: schematic MSGP_rev2.sch]

Parts:
C1, C3, C4: 100uF; C1206K
C2: 10uF; C1206K
C5: 0.1uF; C1206K
IC1, IC3, IC4: 74ALS04D; SO14
IC2: NE5532D; SO08
JP1, JP2, JP3, JP4, JP5, JP6, JP7, JP8, JP9, JP10, JP11, JP12, JP13, JP14, JP15: JP1E; JP1
R1, R2, R3, R4, R5, R6, R7, R8, R9, R10, R11, R12, R13, R14, R15, R16, R17, R18, R19: R-US_0204/2V; 0204V
U1: LTC6905CS5TRMPBF; SOT95P280X100-5N
USBMINI: USBMINIB; USB-MINIB

Connections:
GNDA: C1.2, C2.2, C3.2, C4.2, C5.2, IC2.3 (+IN), IC2.4 (V-), IC2.5 (+IN), JP1.2, JP2.1, JP4.2, JP5.2, JP6.2, JP7.2, JP13.2, USBMINI.GND
GND_D: IC1.7 (GND), IC3.7 (GND), IC4.7 (GND), JP5.1, JP6.1, R1.2, R2.2, R3.2, R4.2, R5.2, R7.2, R8.2, R9.2, R10.2, R11.2, R12.2, R13.2, R14.2, R15.2, R16.2, R17.2, R18.2, R19.2, U1.2 (GND)
unnamed: IC1.1 (I), IC1.3 (I), IC1.5 (I), IC1.9 (I), IC1.11 (I), IC1.13 (I), IC3.1 (I), IC3.3 (I), IC3.5 (I), IC3.9 (I), IC3.11 (I), IC3.13 (I), IC4.1 (I), IC4.3 (I), IC4.5 (I), IC4.9 (I), IC4.11 (I), IC4.13 (I), U1.5 (OUT)
unnamed: IC2.6 (-IN), JP3.2, JP8.1
unnamed: IC2.1 (OUT), JP1.1, JP9.2
unnamed: IC1.10 (O), R8.1
unnamed: IC2.2 (-IN), JP9.1, JP10.2
unnamed: R6.2, U1.3 (SET)
unnamed: IC1.2 (O), R1.1
unnamed: IC1.4 (O), R2.1
unnamed: IC1.8 (O), R3.1
unnamed: IC1.6 (O), R7.1
unnamed: IC1.12 (O), R9.1
unnamed: IC2.7 (OUT), JP7.1, JP8.2
unnamed: IC3.10 (O), R12.1
unnamed: IC4.14 (VCC), JP11.1
unnamed: IC3.2 (O), R4.1
unnamed: IC3.4 (O), R5.1
unnamed: IC3.8 (O), R10.1
unnamed: IC3.6 (O), R11.1
unnamed: IC3.12 (O), R13.1
unnamed: IC4.10 (O), R18.1
unnamed: IC1.14 (VCC), JP14.1
unnamed: IC4.2 (O), R14.1
unnamed: IC4.4 (O), R15.1
unnamed: IC4.8 (O), R16.1
unnamed: IC4.6 (O), R17.1
unnamed: IC4.12 (O), R19.1
unnamed: IC3.14 (VCC), JP15.1
unnamed: JP2.2, JP3.1, JP10.1
VCC: C1.1, C2.1, C3.1, C4.1, C5.1, IC2.8 (V+), JP4.1, JP11.2, JP12.1, JP12.2, JP13.1, JP14.2, JP15.2, R6.1, U1.1 (V+), U1.4 (DIV), USBMINI.VBUS

Notes on the sheet:
5V Test Point

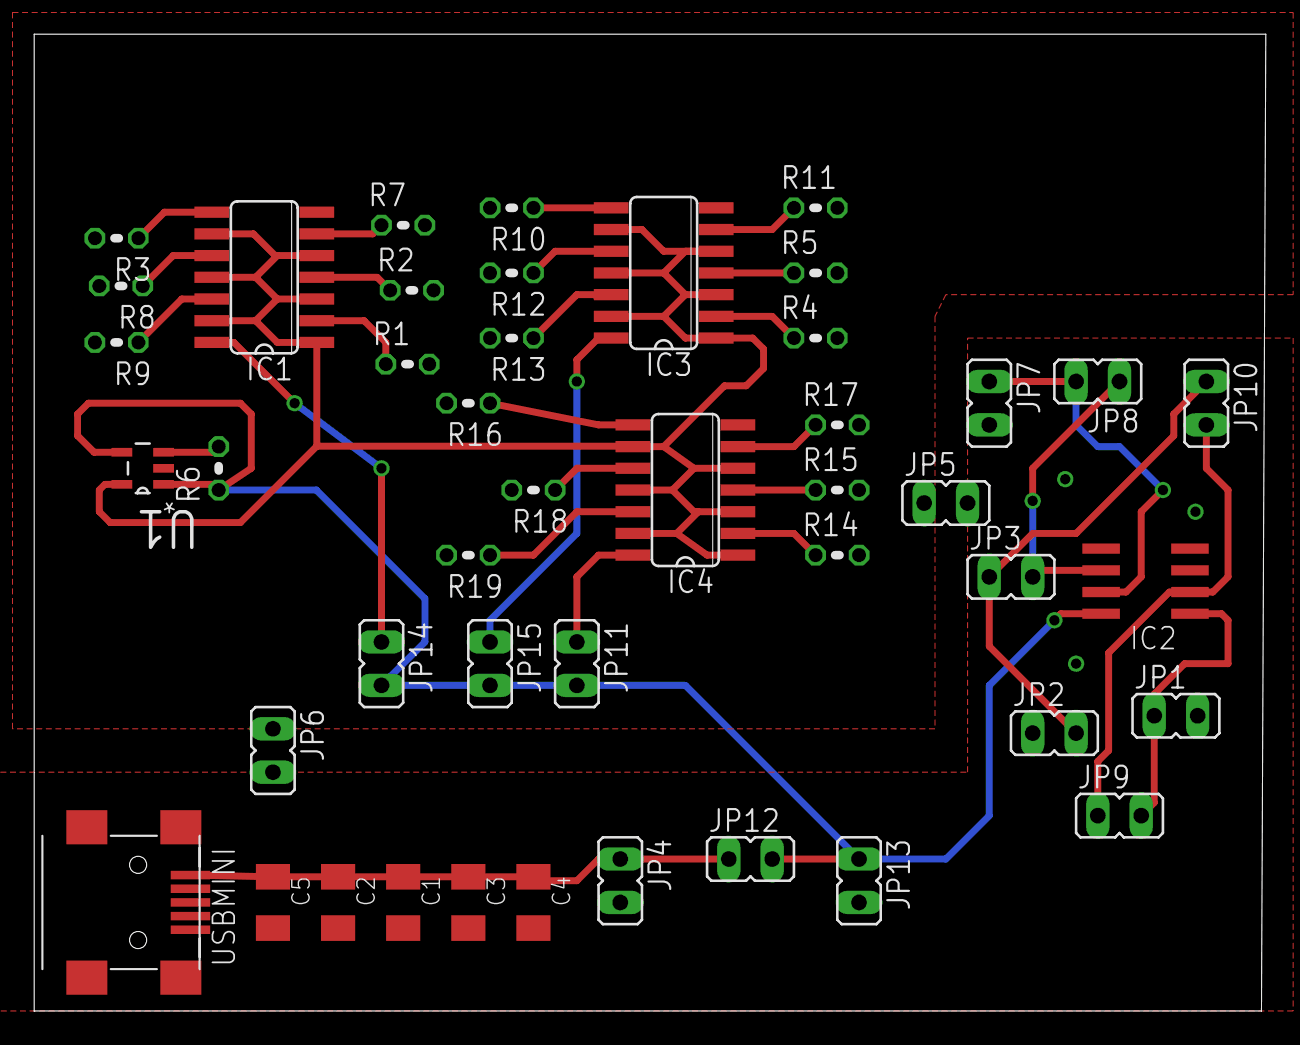
[picture p36: board MSGP_rev2.brd from above]

Board: 2 copper layers, 72.1 x 57.1 mm, 45 parts (0 on the bottom side), 31 nets.
