BrandonTowell/Capstone-Team-12/Eagle/MSGP/Clock.brd

## EAGLE design Eagle/MSGP/Clock.brd (2015-05-25)

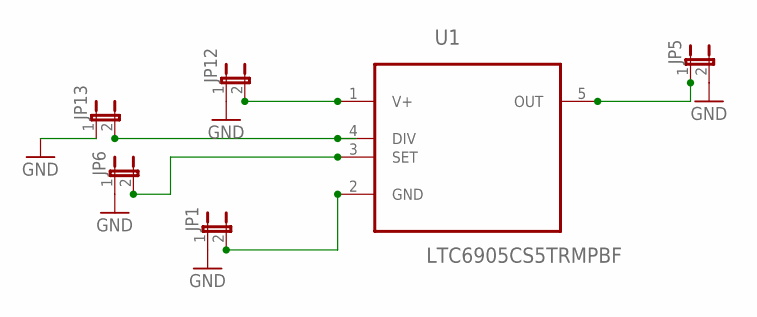
[picture p37: schematic Clock.sch]

Parts:
JP1, JP5, JP6, JP12, JP13: JP1E; JP1
U1: LTC6905CS5TRMPBF; SOT95P280X100-5N

Connections:
GND: JP1.1, JP5.2, JP6.1, JP12.1, JP13.1
unnamed: JP12.2, U1.1 (V+)
unnamed: JP13.2, U1.4 (DIV)
unnamed: JP6.2, U1.3 (SET)
unnamed: JP1.2, U1.2 (GND)
unnamed: JP5.1, U1.5 (OUT)

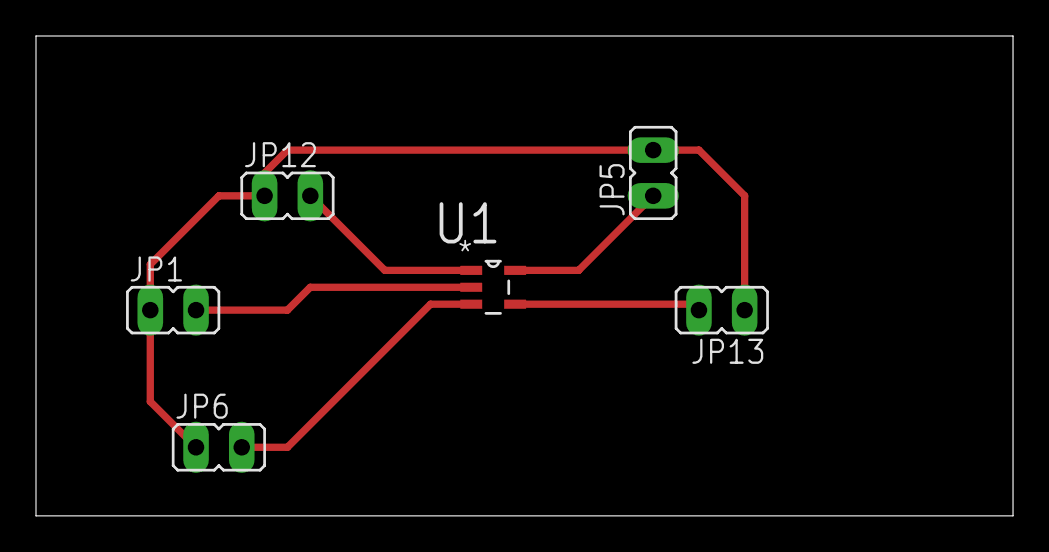
[picture p38: board Clock.brd from above]

Board: 2 copper layers, 54.3 x 26.7 mm, 6 parts (0 on the bottom side), 6 nets.
