BrandonTowell/Capstone-Team-12/Eagle/xnor.brd

## EAGLE design Eagle/xnor.brd (2015-05-21)

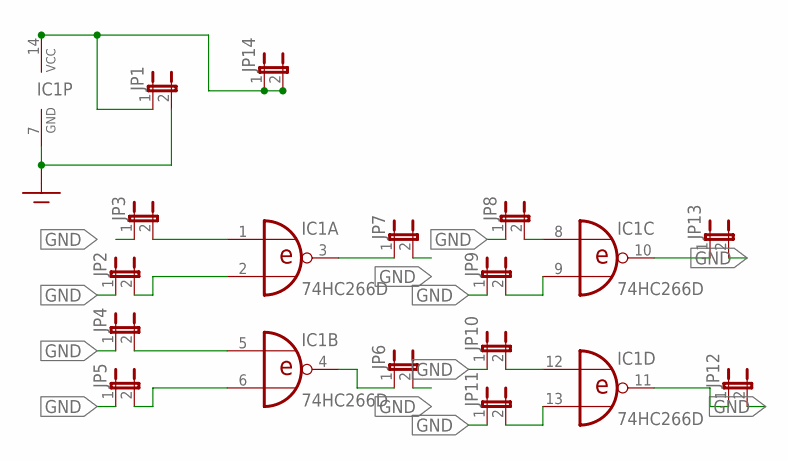
[picture p39: schematic xnor.sch]

Parts:
IC1: 74HC266D; SO14
JP1, JP2, JP3, JP4, JP5, JP6, JP7, JP8, JP9, JP10, JP11, JP12, JP13, JP14: JP1E; JP1

Connections:
GND: IC1.7 (GND), JP1.2, JP2.1, JP3.1, JP4.1, JP5.1, JP6.2, JP7.2, JP8.1, JP9.1, JP10.1, JP11.1, JP12.2, JP13.2
unnamed: IC1.10 (O), JP13.1
unnamed: IC1.1 (I0), JP3.2
unnamed: IC1.2 (I1), JP2.2
unnamed: IC1.5 (I0), JP4.2
unnamed: IC1.6 (I1), JP5.2
unnamed: IC1.4 (O), JP6.1
unnamed: IC1.3 (O), JP7.1
unnamed: IC1.8 (I0), JP8.2
unnamed: IC1.9 (I1), JP9.2
unnamed: IC1.12 (I0), JP10.2
unnamed: IC1.13 (I1), JP11.2
unnamed: IC1.11 (O), JP12.1
VCC: IC1.14 (VCC), JP1.1, JP14.1, JP14.2

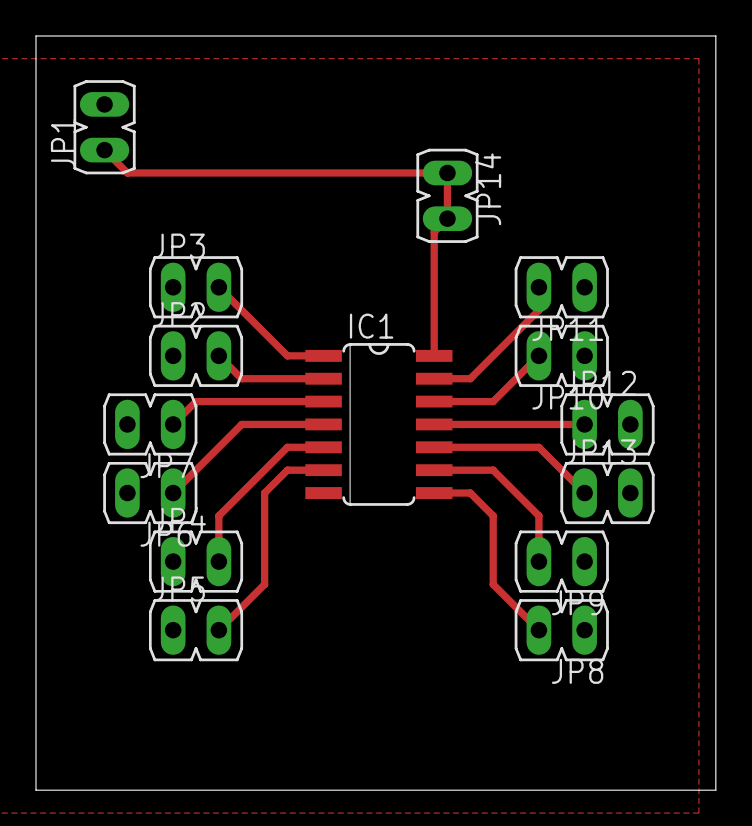
[picture p40: board xnor.brd from above]

Board: 2 copper layers, 37.8 x 41.9 mm, 15 parts (0 on the bottom side), 14 nets.
