BrandonTowell/Capstone-Team-12/Eagle/ISIV2/testboard.brd

## EAGLE design Eagle/ISIV2/testboard.brd (2015-04-30)

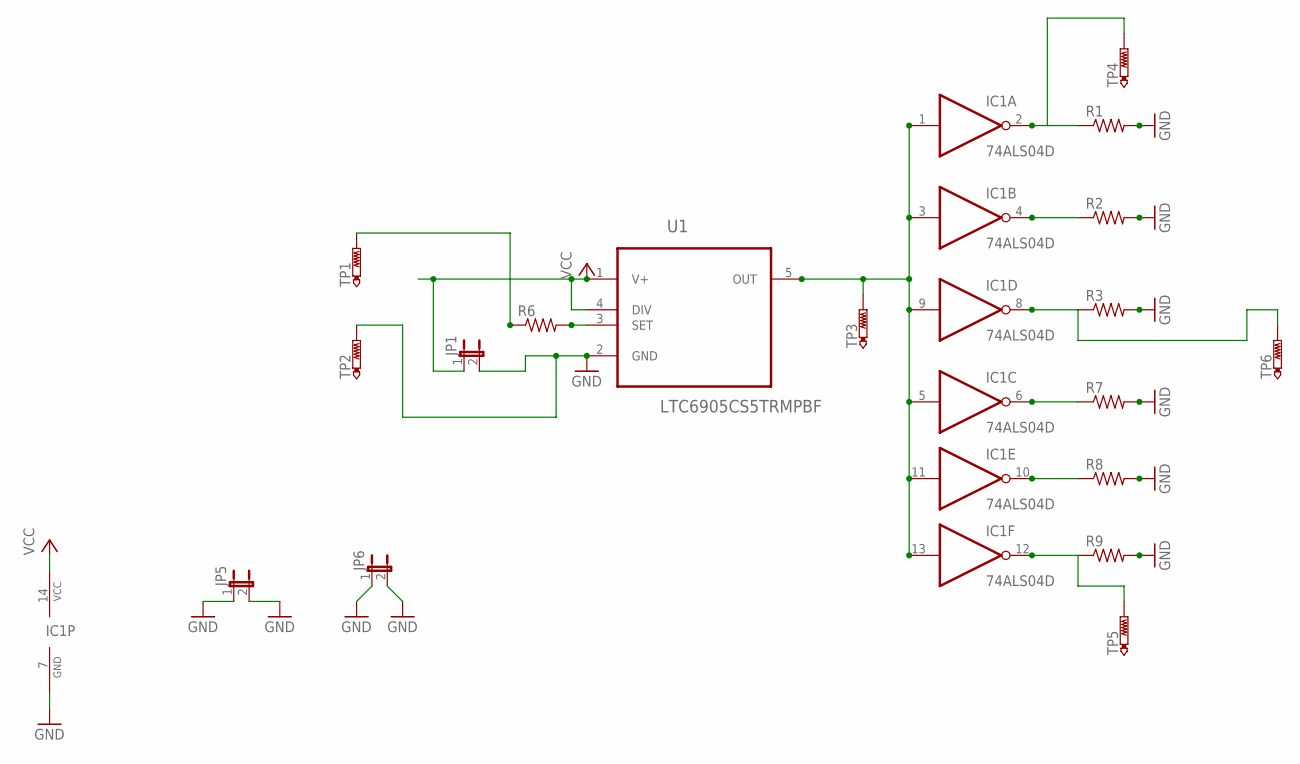
[picture p41: schematic testboard.sch]

Parts:
IC1: 74ALS04D; SO14
JP1, JP5, JP6: JP1E; JP1
R1, R2, R3, R6, R7, R8, R9: R-US_0204/2V; 0204V
TP1, TP2, TP3, TP4, TP5, TP6: PTR1B2,54; B2,54
U1: LTC6905CS5TRMPBF; SOT95P280X100-5N

Connections:
GND: IC1.7 (GND), JP1.2, JP5.1, JP5.2, JP6.1, JP6.2, R1.2, R2.2, R3.2, R7.2, R8.2, R9.2, TP2.TP, U1.2 (GND)
unnamed: IC1.1 (I), IC1.3 (I), IC1.5 (I), IC1.9 (I), IC1.11 (I), IC1.13 (I), TP3.TP, U1.5 (OUT)
unnamed: IC1.10 (O), R8.1
unnamed: R6.2, U1.3 (SET)
unnamed: IC1.2 (O), R1.1, TP4.TP
unnamed: IC1.4 (O), R2.1
unnamed: IC1.8 (O), R3.1, TP6.TP
unnamed: IC1.6 (O), R7.1
unnamed: IC1.12 (O), R9.1, TP5.TP
VCC: IC1.14 (VCC), JP1.1, R6.1, TP1.TP, U1.1 (V+), U1.4 (DIV)

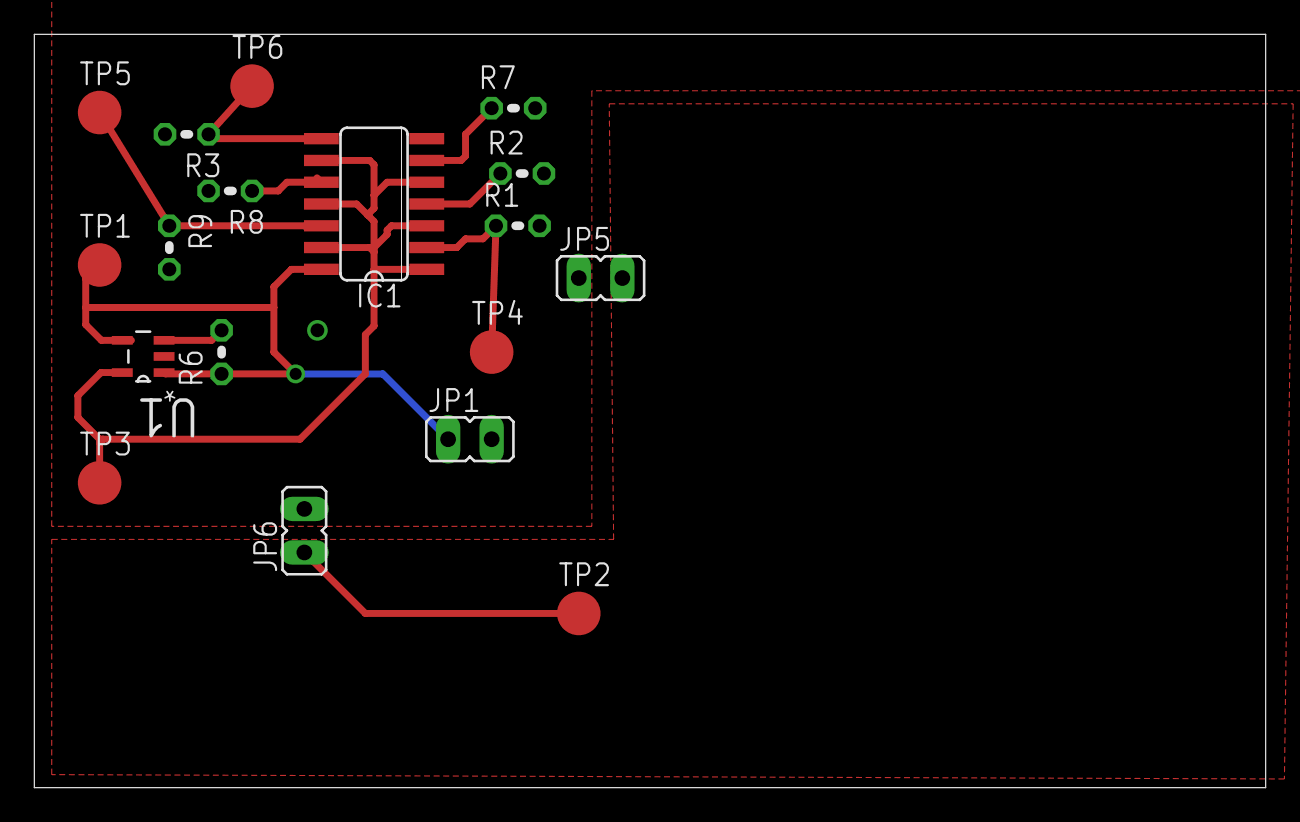
[picture p42: board Eagle/ISIV2/testboard.brd from above]

Board: 2 copper layers, 71.8 x 43.9 mm, 18 parts (0 on the bottom side), 10 nets.
