BrandonTowell/Capstone-Team-12/Eagle/MSGP/testboard.brd

## EAGLE design Eagle/MSGP/testboard.brd (2015-04-26)

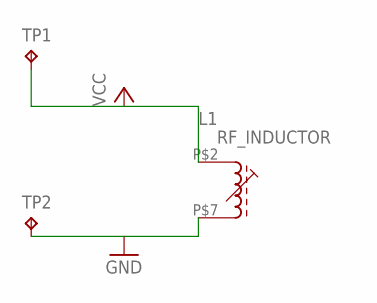
[picture p43: schematic testboard.sch]

Parts:
L1: RF_INDUCTOR; ADJ_IND_NON_STD_PKG
TP1, TP2: TPB2,54; B2,54

Connections:
GND: L1.P$7 (E1), TP2.TP
VCC: L1.P$2 (A1), TP1.TP

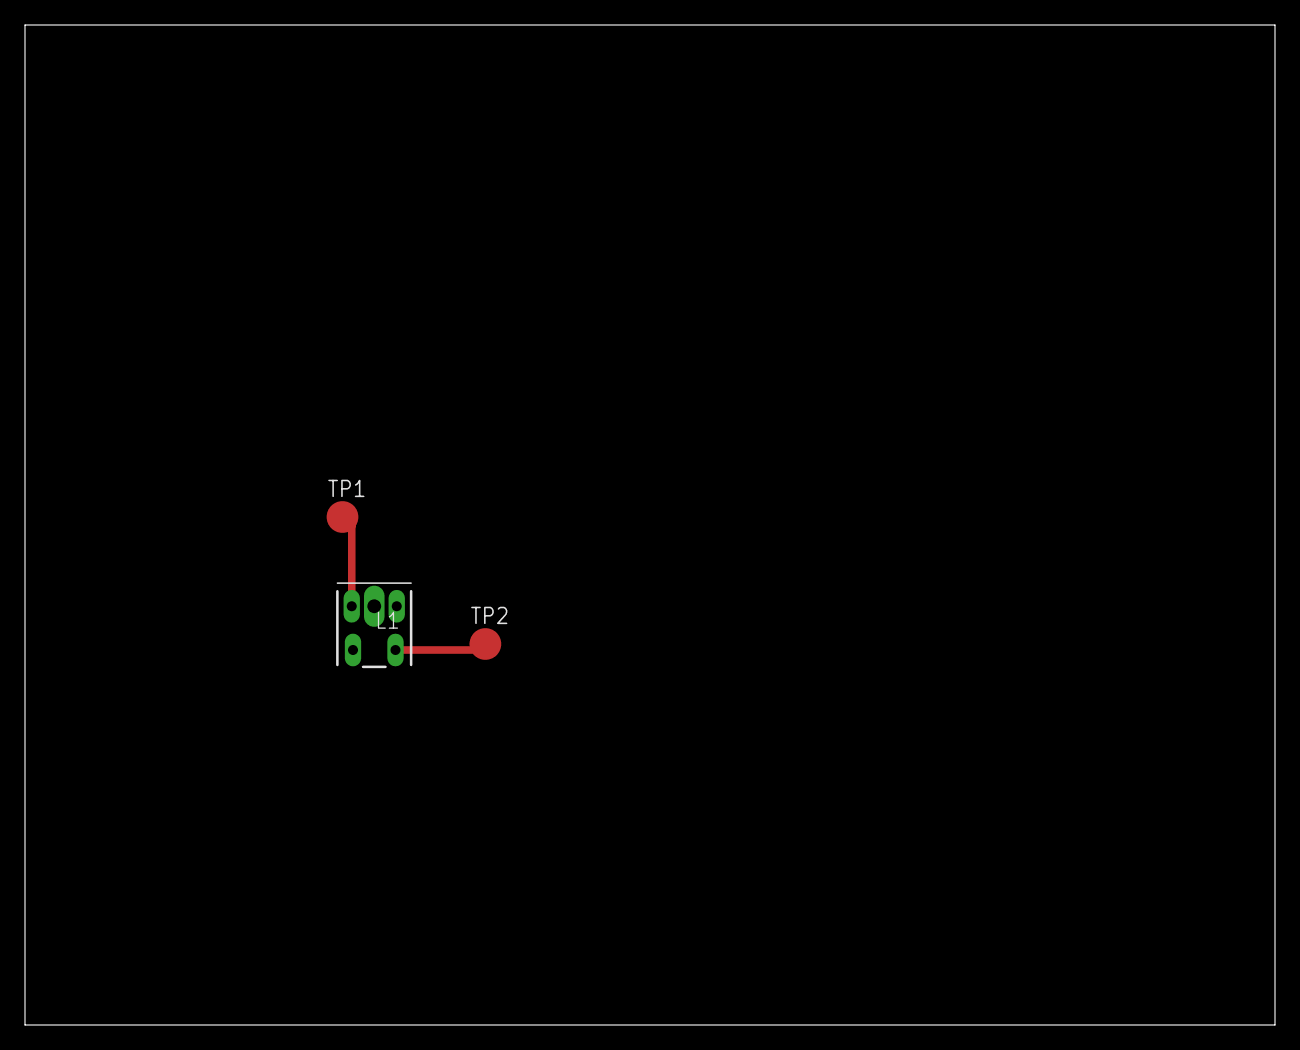
[picture p44: board Eagle/MSGP/testboard.brd from above]

Board: 2 copper layers, 100.0 x 80.0 mm, 3 parts (0 on the bottom side), 2 nets.
