BrandonTowell/Capstone-Team-12/(commit log)

2015-03-07 ISI experiment
    Test upload
    [ISI_experiement.sch]
2015-03-07 Added Archive documentation
    [Capstone Time(2).xlsx, Capstone Time.xlsx]
2015-03-07 Current Documentation
2015-03-10 add it WPR and schematic
2015-03-12 changed flip-flop
    changed flip flop to ordered part, original part was not available at
    DigiKey
    [ISI_experiement.sch]
2015-03-12 Added Research Folder
    Added research folder and added research papers for mixed signal devices
2015-03-14 WPR and Connector description
2015-03-14 BOM and WPR
    [BillOfMaterials.xlsx]
2015-03-14 Split subtotals
    [BillOfMaterials.xlsx]
2015-03-16 WPR
    WPR and some progress LSFR pattern generation for crosstalk aspect of
    the experiment.
    [LSFR-V2.xlsx]
2015-03-25 Naming update
    [LSFR-V2.xlsx]
2015-03-27 ISI part library
    Started part library with schematic and parts both on mm to match what
    Kris wanted
    [ISI_experiement.sch]
2015-03-29 added items to library
    added single pin header and inverted buffer
    [ISI_experiement.sch]
2015-03-30 minor changes
    added some parts and ensure parts were worked on both schematic and
    board.
    [BillOfMaterials.xlsx, ISI_experiement.brd, ISI_experiement.sch]
2015-04-01 Update to docs
    Updated BOM and added goal to ISI experiment description
    [BillOfMaterials.xlsx]
2015-04-01 Created Connector Reliability
2015-04-01 Updated Connector document
2015-04-02 schematic for power supply
    [PowerSupply.sch]
2015-04-03 merge power
    needs more work just uploaded to save progress
    [ISI_experiement.brd, ISI_experiement.sch]
2015-04-03 for got this
    [ISI_experiement.sch]
2015-04-04 added aggressor and LFSR
    need to add a clock and review a inductor part and schematic
    [ISI_experiement.brd, ISI_experiement.sch]
2015-04-04 made space for clock
    [ISI_experiement.sch]
2015-04-04 clk sch
    [Clock.sch]
2015-04-04 MSGP sch
    [MSGP.sch]
2015-04-05 Update Schematic
2015-04-05 wrong file uploaded
    [MSGP.brd]
2015-04-05 MSBP board
    [MSGP.brd, MSGP.sch]
2015-04-05 new MSGP
    [Clock.sch, ISI_experiement.brd, ISI_experiement.sch, MSGP.brd, MSGP.sch]
2015-04-05 added clock to ISI
    clock and labels added and some minor appearance changes
    [ISI_experiement.sch]
2015-04-05 WPR
    current week WPR
2015-04-06 really close to final ISI
    missing inductor package dimensions and one cap value.
    [ISI_experiement.brd, ISI_experiement.sch]
2015-04-09 Updated ISI schematic and board
    [ISI_experiement.brd, ISI_experiement.sch]
2015-04-10 ISI updated
    Still need to make 2 parts but that should no affect routing of LFSR.
    [ISI_experiement.brd, ISI_experiement.sch]
2015-04-12 Update Eagle Schematic
2015-04-12 MSGP board
    placed but not route
    [MSGP.brd, MSGP.sch]
2015-04-12 MSGP schematic
    [MSGP.sch]
2015-04-15 Schematic/Layout Update
2015-04-15 fixed polygon
    Because Eagle is dumb….
    [MSGP.brd]
2015-04-16 first run full layout of isi board
    [ISI_experiement.brd, ISI_experiement.sch]
2015-04-17 upload latest isi board
    [ISI_experiement.brd, ISI_experiement.sch]
2015-04-18 MSG layout
    [MSGP.sch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]
2015-04-18 added wpr and berbers for msg experiment
    [MSGP.drills.xln]
2015-04-20 some changes to the traces
    [BillOfMaterials.xlsx, ISI_experiement.brd, ISI_experiement.sch]
2015-04-21 ISI with test points
    added test point to near and far end of TL
    [ISI_experiement.brd, ISI_experiement.sch]
2015-04-23 Updated Schematic
    [MSGP.brd, MSGP.sch]
2015-04-26 test board included
    [ISI_experiement.brd, MSGP.brd, MSGP.sch, testboard.brd, testboard.sch]
2015-04-26 test board
    debug board
    [ISI_experiement.brd, testboard.brd, testboard.sch]
2015-04-30 version sent to oshpark
    [ISI_experiement.brd, ISI_experiement.sch]
2015-04-30 WPRs and Test Board
    Test board layout
    [testboard.brd, testboard.sch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]
2015-05-10 some clean up
    [MSGP.sch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]
2015-05-21 late update
    [xnor.brd, xnor.sch]
2015-05-25 changes to git
    [ISI_experiement.brd, ISI_experiement.sch]
2015-05-25 Poster/WPRS
    Update
    [Clock.brd, Clock.sch]
2015-06-07 Updates to Layout/Schem
    [MSGP_rev2.brd, MSGP_rev2.sch]
2015-06-09 updated boards
    fixed some of the issued we encountered while making the board
    [ISI_experiement.brd, ISI_experiement.sch, MSGP_rev2.brd, MSGP_rev2.sch]
2015-06-10 minor changes to MSGP rev2
    change one trace to digital ground
    [MSGP_rev2.brd, MSGP_rev2.sch]
2015-06-10 draft of pass down ISI
    missing summary
    [ISI_experiement.brd, ISI_experiement.sch]
2015-06-10 BOM updated
    [BillOfMaterials_rev2.xlsx]
2015-06-10 updated MSGP
    added clock, opamp and resistor cost
    [BillOfMaterials_rev2.xlsx]
2015-06-11 some changes to report
    added BOM and code
    [BillOfMaterials_rev2.xlsx]
